byte-jlz/MediKiosk_hardware/hardware/bp_results/20261016_195159_110-75-82.jpg

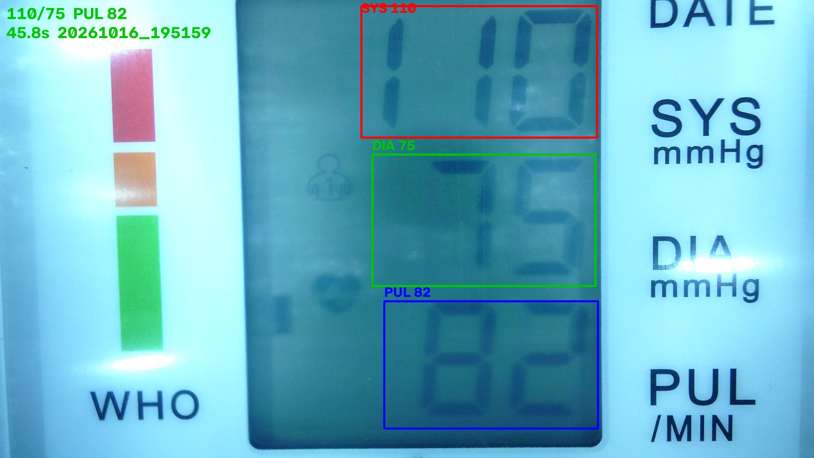
hardware/bp_results/20261016_195159_110-75-82.jpg
