byte-jlz/MediKiosk_hardware/hardware/bp_errors.csv

timestamp | code | message | after_s | picture
20261017_112818 | Er E | The BP monitor showed an error. Please check the cuff. | 17.3 | 20261017_112818_ERROR_ErE.jpg
