byte-jlz/MediKiosk_hardware/hardware/bp_snapshots/20261016_134654_DIA_binary.png

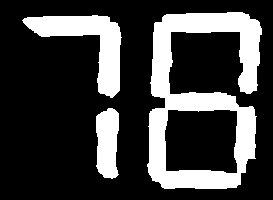
hardware/bp_snapshots/20261016_134654_DIA_binary.png
