byte-jlz/MediKiosk_hardware/hardware/bp_snapshots/20261016_140723_DIA_binary.png

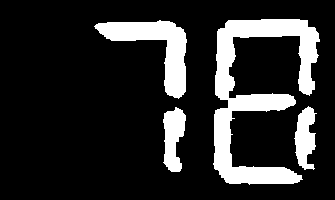
hardware/bp_snapshots/20261016_140723_DIA_binary.png
