byte-jlz/MediKiosk_hardware/hardware/bp_snapshots/20261016_140723_raw.png

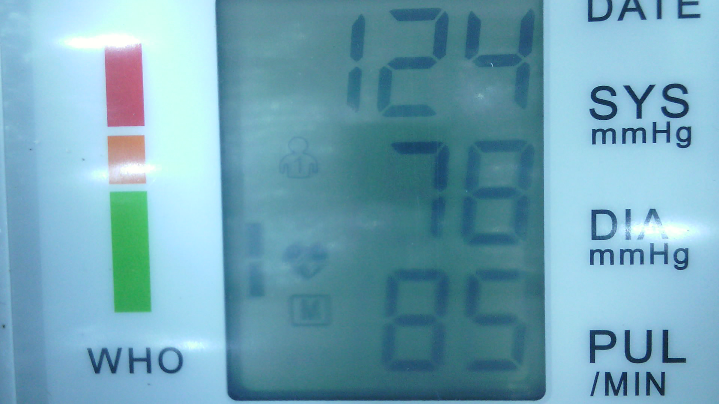
hardware/bp_snapshots/20261016_140723_raw.png
