byte-jlz/MediKiosk_hardware/hardware/bp_snapshots/20261016_141033_DIA_roi.png

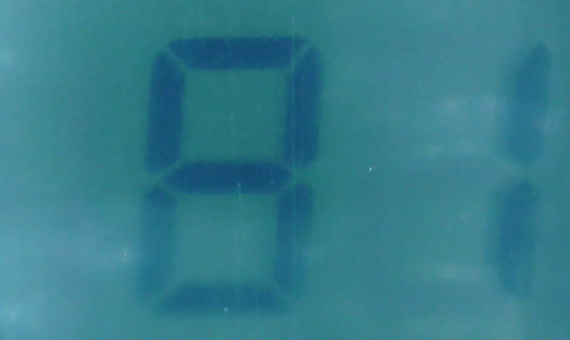
hardware/bp_snapshots/20261016_141033_DIA_roi.png
