byte-jlz/MediKiosk_hardware/hardware/bp_snapshots/20261016_141033_SYS_binary.png

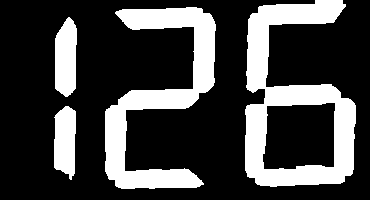
hardware/bp_snapshots/20261016_141033_SYS_binary.png
