byte-jlz/MediKiosk_hardware/hardware/bp_snapshots/20261016_194650_DIA_roi.png

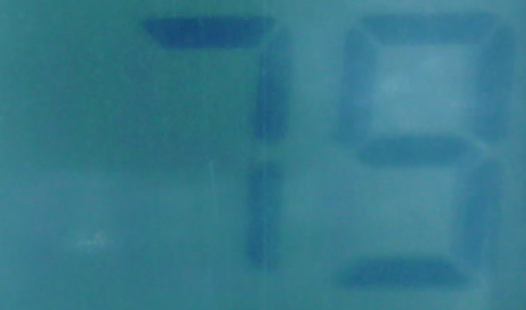
hardware/bp_snapshots/20261016_194650_DIA_roi.png
