byte-jlz/MediKiosk_hardware/hardware/bp_snapshots/20261016_194650_PUL_roi.png

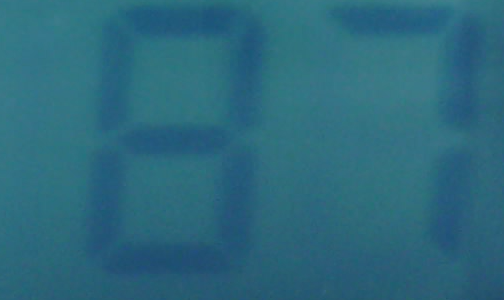
hardware/bp_snapshots/20261016_194650_PUL_roi.png
