byte-jlz/MediKiosk_hardware/hardware/bp_snapshots/20261016_194650_SYS_binary.png

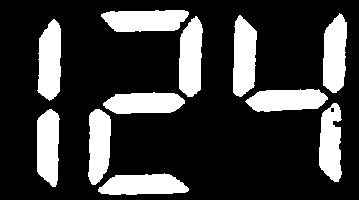
hardware/bp_snapshots/20261016_194650_SYS_binary.png
