byte-jlz/MediKiosk_hardware/hardware/bp_results.csv

timestamp | sys | dia | pul | duration_s | picture
20261016_195159 | 110 | 75 | 82 | 45.8 | 20261016_195159_110-75-82.jpg
20261016_195400 | 121 | 75 | 81 | 42.9 | 20261016_195400_121-75-81.jpg
20261016_202933 | 130 | 80 | 95 | 76.3 | 20261016_202933_130-80-95.jpg
20261016_203119 | 122 | 72 | 96 | 75.6 | 20261016_203119_122-72-96.jpg
20261017_115900 | 122 | 78 | 80 | 51.3 | 20261017_115900_122-78-80.jpg
20261017_120018 | 118 | 73 | 80 | 46.0 | 20261017_120018_118-73-80.jpg
20261017_174749 | 111 | 68 | 84 | 59.3 | 20261017_174749_111-68-84.jpg
20261017_174858 | 111 | 70 | 79 | 42.6 | 20261017_174858_111-70-79.jpg
20261017_175101 | 117 | 83 | 94 | 46.9 | 20261017_175101_117-83-94.jpg
