byte-jlz/MediKiosk_hardware/sensor_test/rr_logs/20261027_222002_rr.csv

t_s | ir_raw | breathing_wave | is_breath_peak
0.000 | 130046 | 785.80 | 0
0.040 | 129939 | 722.78 | 0
0.080 | 130109 | 656.46 | 0
0.121 | 130049 | 587.36 | 0
0.161 | 129944 | 515.99 | 0
0.201 | 129767 | 442.91 | 0
0.241 | 129469 | 368.68 | 0
0.281 | 129190 | 293.88 | 0
0.321 | 129005 | 219.09 | 0
0.362 | 128914 | 144.87 | 0
0.402 | 128876 | 71.80 | 0
0.442 | 128857 | 0.42 | 0
0.482 | 128967 | -68.74 | 0
0.522 | 128993 | -135.19 | 0
0.562 | 128371 | -198.47 | 0
0.603 | 127415 | -258.15 | 0
0.643 | 127007 | -313.85 | 0
0.683 | 126985 | -365.24 | 0
0.723 | 127020 | -412.04 | 0
0.763 | 127170 | -454.02 | 0
0.803 | 127305 | -491.01 | 0
0.844 | 127394 | -522.90 | 0
0.884 | 127473 | -549.64 | 0
0.924 | 127552 | -571.23 | 0
0.964 | 127654 | -587.75 | 0
1.004 | 127962 | -599.31 | 0
1.044 | 128107 | -606.09 | 0
1.085 | 128394 | -608.32 | 0
1.125 | 128363 | -606.30 | 0
1.165 | 127611 | -600.33 | 0
1.205 | 127118 | -590.80 | 0
1.245 | 127052 | -578.10 | 0
1.285 | 127201 | -562.67 | 0
1.326 | 127394 | -544.96 | 0
1.366 | 127635 | -525.46 | 0
1.406 | 127866 | -504.66 | 0
1.446 | 127947 | -483.04 | 0
1.486 | 128108 | -461.11 | 0
1.526 | 128312 | -439.35 | 0
1.567 | 128547 | -418.23 | 0
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
