byte-jlz/MediKiosk_hardware/sensor_test/rr_logs/20261027_223100_rr.csv

t_s | ir_raw | breathing_wave | is_breath_peak
0.000 | 135526 | 323.27 | 0
0.040 | 135669 | 335.74 | 0
0.080 | 135706 | 348.46 | 0
0.121 | 135059 | 361.32 | 0
0.161 | 134633 | 374.15 | 0
0.201 | 134647 | 386.78 | 0
0.241 | 134774 | 399.02 | 0
0.281 | 134884 | 410.67 | 0
0.321 | 135051 | 421.51 | 0
0.362 | 134978 | 431.32 | 0
0.402 | 134910 | 439.89 | 0
0.442 | 134939 | 446.98 | 0
0.482 | 135072 | 452.36 | 0
0.522 | 135227 | 455.83 | 0
0.562 | 135501 | 457.17 | 0
0.603 | 135844 | 456.19 | 0
0.643 | 136310 | 452.70 | 0
0.683 | 136553 | 446.54 | 0
0.723 | 135946 | 437.57 | 0
0.763 | 135580 | 425.69 | 0
0.803 | 135658 | 410.79 | 0
0.844 | 135816 | 392.82 | 0
0.884 | 135895 | 371.76 | 0
0.924 | 135877 | 347.62 | 0
0.964 | 135741 | 320.43 | 0
1.004 | 135520 | 290.28 | 0
1.044 | 135426 | 257.28 | 0
1.085 | 135413 | 221.57 | 0
1.125 | 135399 | 183.33 | 0
1.165 | 135393 | 142.79 | 0
1.205 | 135354 | 100.19 | 0
1.245 | 135335 | 55.81 | 0
1.285 | 135036 | 9.96 | 0
1.326 | 134281 | -37.05 | 0
1.366 | 133806 | -84.85 | 0
1.406 | 133799 | -133.09 | 0
1.446 | 133925 | -181.37 | 0
1.486 | 134072 | -229.31 | 0
1.526 | 134216 | -276.52 | 0
1.567 | 134181 | -322.59 | 0
1.607 | 134252 | -367.14 | 0
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
