byte-jlz/MediKiosk_hardware/sensor_test/rr_logs/20261027_225713_rr.csv

t_s | ir_raw | breathing_wave | is_breath_peak
0.000 | 133057 | 342.77 | 0
0.040 | 133068 | 272.78 | 0
0.080 | 133141 | 198.92 | 0
0.121 | 133219 | 121.78 | 0
0.161 | 133161 | 42.00 | 0
0.201 | 133014 | -39.77 | 0
0.241 | 132797 | -122.84 | 0
0.281 | 132703 | -206.52 | 0
0.321 | 132675 | -290.09 | 0
0.362 | 132749 | -372.86 | 0
0.402 | 132847 | -454.14 | 0
0.442 | 132925 | -533.24 | 0
0.482 | 132930 | -609.50 | 0
0.522 | 132919 | -682.30 | 0
0.562 | 132529 | -751.05 | 0
0.603 | 132062 | -815.20 | 0
0.643 | 131988 | -874.25 | 0
0.683 | 132135 | -927.75 | 0
0.723 | 132269 | -975.31 | 0
0.763 | 132431 | -1016.61 | 0
0.803 | 132473 | -1051.37 | 0
0.844 | 132494 | -1079.40 | 0
0.884 | 132511 | -1100.57 | 0
0.924 | 132620 | -1114.82 | 0
0.964 | 132705 | -1122.16 | 0
1.004 | 132745 | -1122.66 | 0
1.044 | 132787 | -1116.45 | 0
1.085 | 132830 | -1103.75 | 0
1.125 | 132870 | -1084.82 | 0
1.165 | 132623 | -1059.98 | 0
1.205 | 132153 | -1029.60 | 0
1.245 | 132051 | -994.09 | 0
1.285 | 132169 | -953.93 | 0
1.326 | 132378 | -909.60 | 0
1.366 | 132529 | -861.64 | 0
1.406 | 132566 | -810.58 | 0
1.446 | 132562 | -757.00 | 0
1.486 | 132533 | -701.47 | 0
1.526 | 132574 | -644.57 | 0
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
