byte-jlz/MediKiosk_hardware/sensor_test/rr_logs/20261028_120343_rr.csv

t_s | ir_raw | breathing_wave | is_breath_peak
0.000 | 135555 | -902.75 | 0
0.040 | 135792 | -984.55 | 0
0.080 | 136022 | -1064.28 | 0
0.121 | 136242 | -1141.34 | 0
0.161 | 136420 | -1215.16 | 0
0.201 | 136638 | -1285.15 | 0
0.241 | 136594 | -1350.75 | 0
0.281 | 136010 | -1411.41 | 0
0.321 | 135405 | -1466.64 | 0
0.362 | 135266 | -1515.94 | 0
0.402 | 135384 | -1558.87 | 0
0.442 | 135621 | -1595.02 | 0
0.482 | 135834 | -1624.06 | 0
0.522 | 135952 | -1645.67 | 0
0.562 | 136068 | -1659.60 | 0
0.603 | 136201 | -1665.67 | 0
0.643 | 136356 | -1663.74 | 0
0.683 | 136552 | -1653.74 | 0
0.723 | 136723 | -1635.68 | 0
0.763 | 136900 | -1609.60 | 0
0.803 | 137098 | -1575.62 | 0
0.844 | 137306 | -1533.93 | 0
0.884 | 137314 | -1484.77 | 0
0.924 | 136817 | -1428.44 | 0
0.964 | 136160 | -1365.29 | 0
1.004 | 135872 | -1295.73 | 0
1.044 | 135888 | -1220.22 | 0
1.085 | 136011 | -1139.26 | 0
1.125 | 136263 | -1053.37 | 0
1.165 | 136437 | -963.15 | 0
1.205 | 136639 | -869.18 | 0
1.245 | 136739 | -772.09 | 0
1.286 | 136982 | -672.51 | 0
1.326 | 137271 | -571.10 | 0
1.366 | 137633 | -468.52 | 0
1.406 | 138108 | -365.41 | 0
1.446 | 138575 | -262.41 | 0
1.486 | 138995 | -160.17 | 0
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
