byte-jlz/MediKiosk_hardware/sensor_test/rr_logs/20261028_202421_rr.csv

t_s | ir_raw | breathing_wave | is_breath_peak
0.000 | 149123 | -666.49 | 0
0.040 | 149170 | -760.16 | 0
0.080 | 148904 | -851.47 | 0
0.120 | 148678 | -939.83 | 0
0.161 | 148620 | -1024.69 | 0
0.201 | 148693 | -1105.50 | 0
0.241 | 148778 | -1181.77 | 0
0.281 | 148919 | -1253.04 | 0
0.321 | 148963 | -1318.90 | 0
0.361 | 149041 | -1378.97 | 0
0.402 | 149087 | -1432.94 | 0
0.442 | 149170 | -1480.54 | 0
0.482 | 149294 | -1521.55 | 0
0.522 | 149432 | -1555.83 | 0
0.562 | 149545 | -1583.27 | 0
0.602 | 149667 | -1603.83 | 0
0.643 | 149460 | -1617.52 | 0
0.683 | 149168 | -1624.41 | 0
0.723 | 149096 | -1624.62 | 0
0.763 | 149194 | -1618.33 | 0
0.803 | 149282 | -1605.74 | 0
0.843 | 149420 | -1587.13 | 0
0.884 | 149444 | -1562.80 | 0
0.924 | 149527 | -1533.09 | 0
0.964 | 149582 | -1498.38 | 0
1.004 | 149625 | -1459.05 | 0
1.044 | 149641 | -1415.55 | 0
1.084 | 149705 | -1368.30 | 0
1.125 | 149849 | -1317.77 | 0
1.165 | 149841 | -1264.41 | 0
1.205 | 149493 | -1208.69 | 0
1.245 | 149195 | -1151.06 | 0
1.285 | 149109 | -1091.98 | 0
1.325 | 149192 | -1031.90 | 0
1.366 | 149268 | -971.23 | 0
1.406 | 149384 | -910.39 | 0
1.446 | 149444 | -849.75 | 0
1.486 | 149491 | -789.67 | 0
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
