byte-jlz/MediKiosk_hardware/sensor_test/rr_logs/20261030_133937_rr.csv

t_s | ir_raw | breathing_wave | is_breath_peak
0.000 | 114373 | -23.34 | 0
0.040 | 114512 | 34.70 | 0
0.080 | 114604 | 91.16 | 0
0.121 | 114684 | 145.60 | 0
0.161 | 114757 | 197.61 | 0
0.201 | 114819 | 246.81 | 0
0.241 | 114880 | 292.87 | 0
0.281 | 114835 | 335.46 | 0
0.321 | 114468 | 374.31 | 0
0.362 | 114209 | 409.20 | 0
0.402 | 114192 | 439.93 | 0
0.442 | 114078 | 466.38 | 0
0.482 | 114093 | 488.43 | 0
0.522 | 114192 | 506.06 | 0
0.562 | 114142 | 519.25 | 0
0.603 | 114206 | 528.05 | 0
0.643 | 114200 | 532.56 | 0
0.683 | 114290 | 532.91 | 0
0.723 | 114347 | 529.27 | 0
0.763 | 114434 | 521.87 | 0
0.803 | 114519 | 510.95 | 0
0.844 | 114580 | 496.79 | 0
0.884 | 114698 | 479.71 | 0
0.924 | 114560 | 460.03 | 0
0.964 | 114241 | 438.11 | 0
1.004 | 113954 | 414.32 | 0
1.045 | 113869 | 389.04 | 0
1.085 | 113804 | 362.63 | 0
1.125 | 113802 | 335.49 | 0
1.165 | 113895 | 307.98 | 0
1.205 | 113915 | 280.48 | 0
1.245 | 113990 | 253.33 | 0
1.286 | 114033 | 226.86 | 0
1.326 | 114066 | 201.39 | 0
1.366 | 114148 | 177.20 | 0
1.406 | 114213 | 154.54 | 0
1.446 | 114337 | 133.64 | 0
1.486 | 114403 | 114.68 | 0
1.527 | 114524 | 97.81 | 0
1.567 | 114633 | 83.16 | 0
1.607 | 114396 | 70.80 | 0
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
