byte-jlz/MediKiosk_hardware/sensor_test/rr_logs/20261027_223100_rr.png

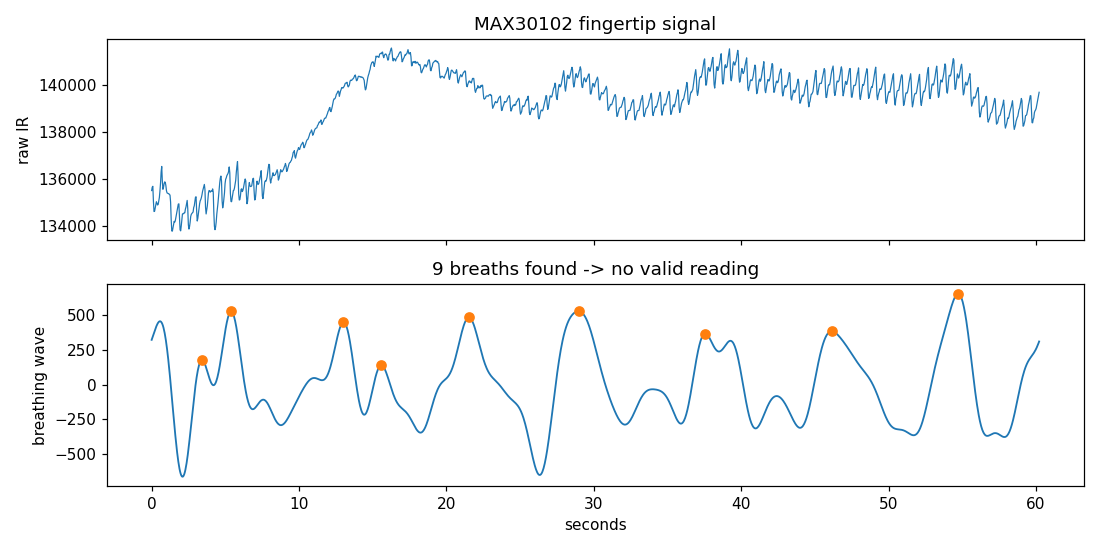
sensor_test/rr_logs/20261027_223100_rr.png
