byte-jlz/MediKiosk_hardware/sensor_test/rr_logs/20261027_225713_rr.png

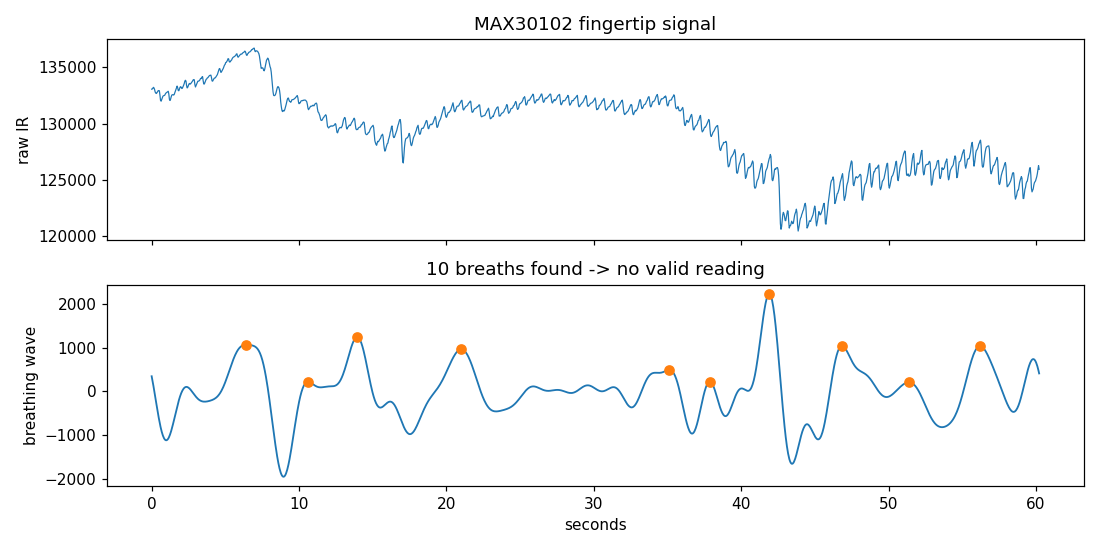
sensor_test/rr_logs/20261027_225713_rr.png
