byte-jlz/MediKiosk_hardware/sensor_test/rr_logs/20261027_234313_rr.png

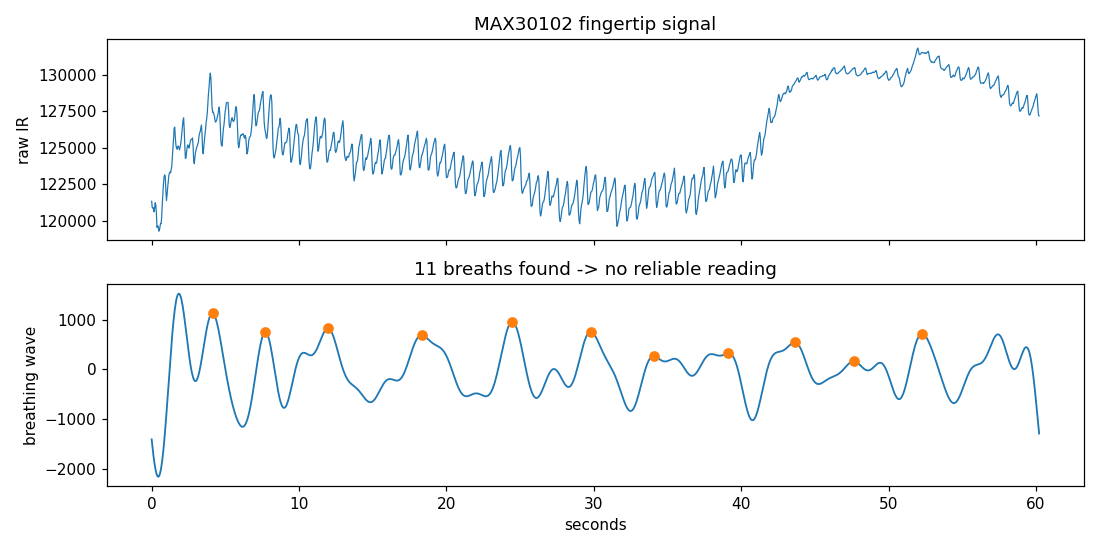
sensor_test/rr_logs/20261027_234313_rr.png
