byte-jlz/MediKiosk_hardware/sensor_test/rr_logs/20261028_201018_rr.png

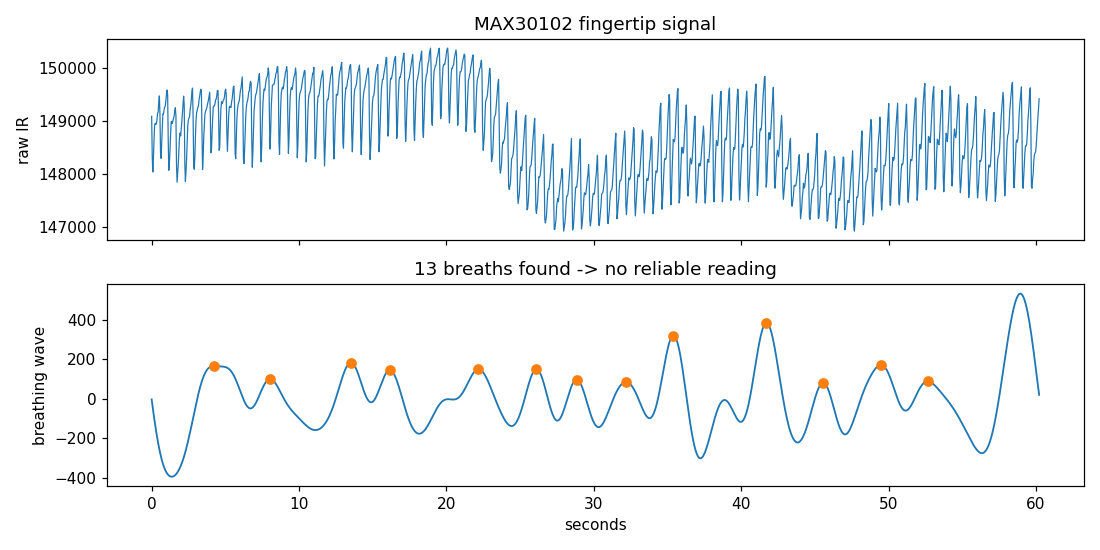
sensor_test/rr_logs/20261028_201018_rr.png
