byte-jlz/MediKiosk_hardware/sensor_test/rr_logs/20261028_202421_rr.png

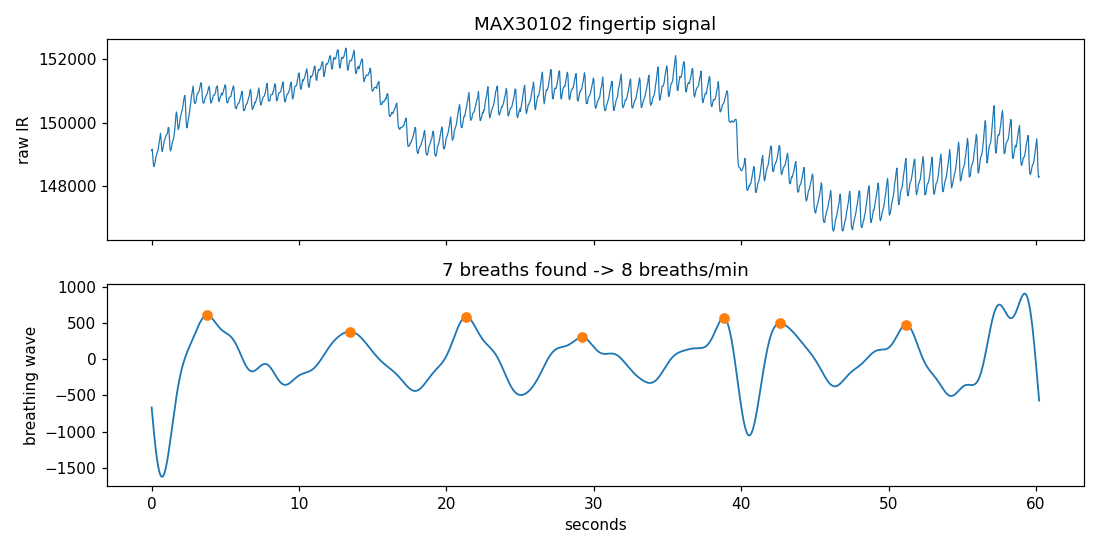
sensor_test/rr_logs/20261028_202421_rr.png
