byte-jlz/MediKiosk_hardware/sensor_test/rr_logs/20261028_204124_rr.png

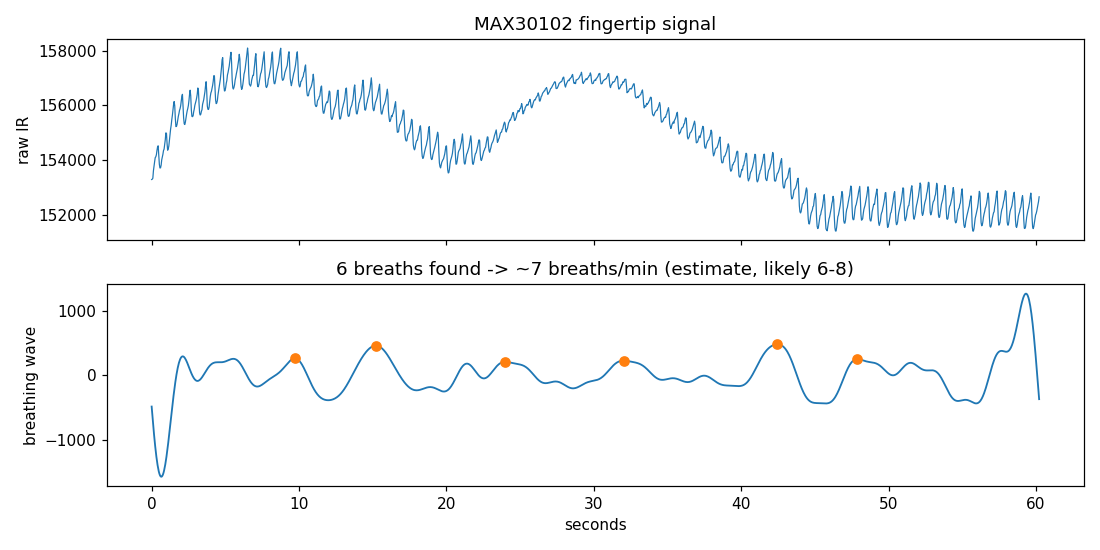
sensor_test/rr_logs/20261028_204124_rr.png
