byte-jlz/MediKiosk_hardware/sensor_test/rr_logs/20261030_083011_rr.png

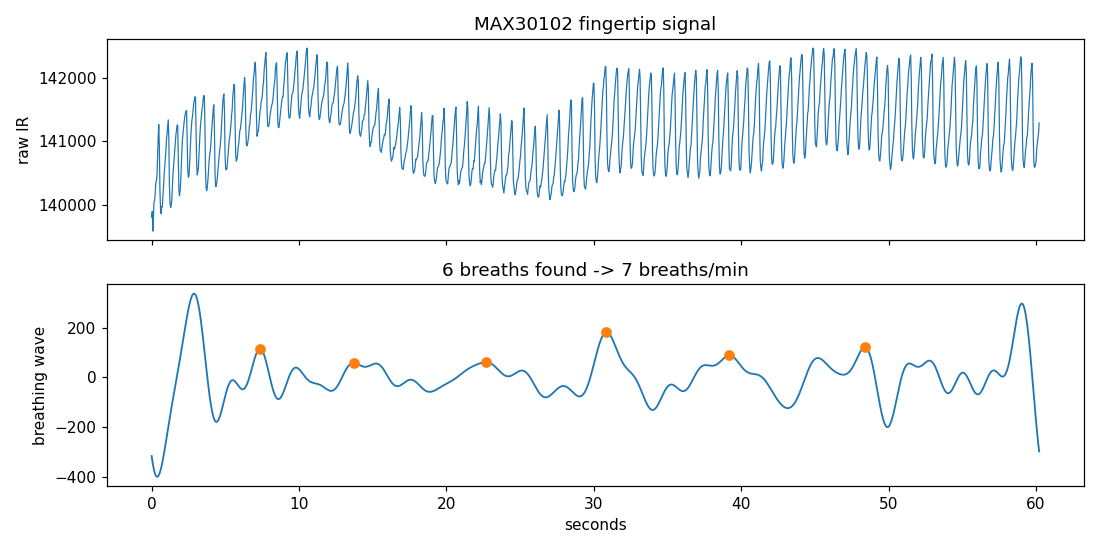
sensor_test/rr_logs/20261030_083011_rr.png
