byte-jlz/MediKiosk_hardware/sensor_test/rr_logs/20261031_175543_rr.png

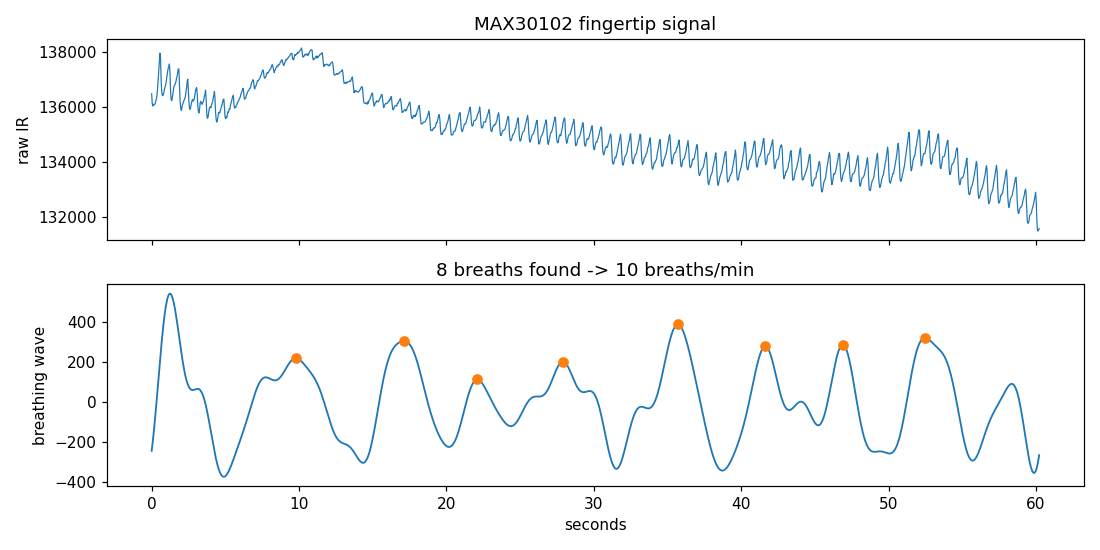
sensor_test/rr_logs/20261031_175543_rr.png
