byte-jlz/MediKiosk_hardware/sensor_test/rr_logs/20261031_182348_rr.png

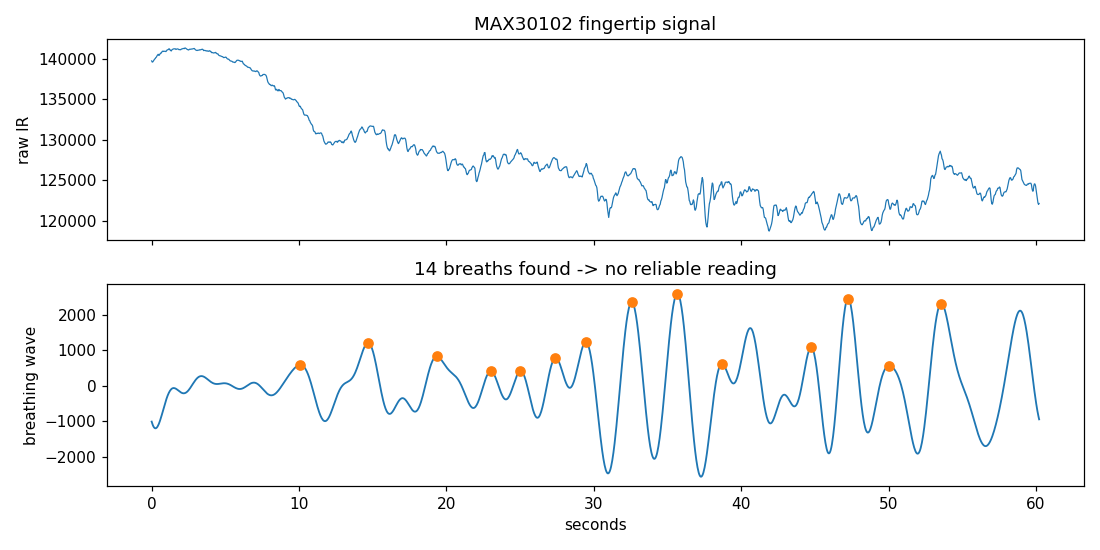
sensor_test/rr_logs/20261031_182348_rr.png
