byte-jlz/MediKiosk_hardware/sensor_test/rr_logs/20261031_184331_rr.png

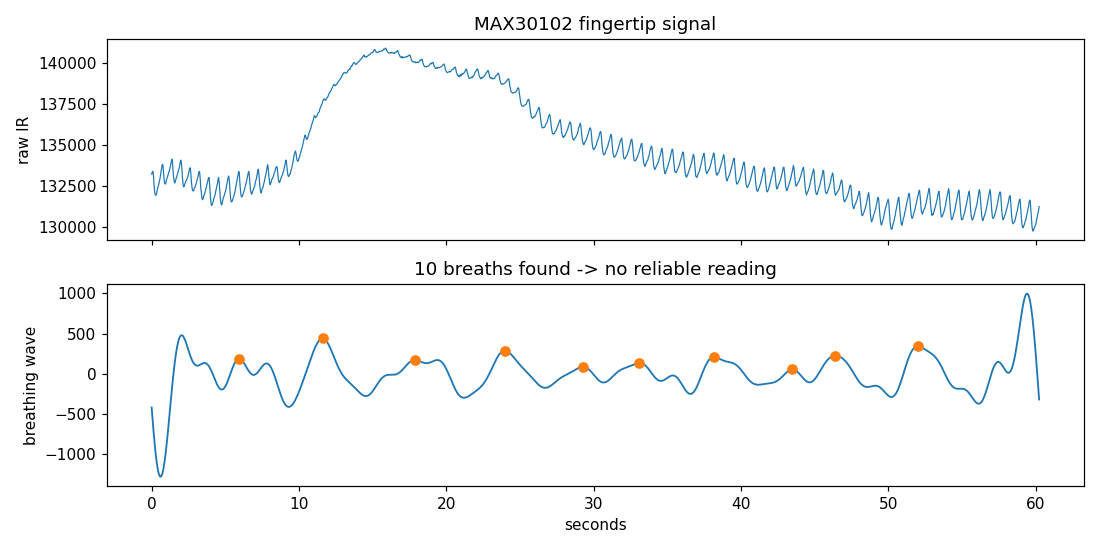
sensor_test/rr_logs/20261031_184331_rr.png
