byte-jlz/MediKiosk_hardware/test_tof.py

import time
import board
import busio
import adafruit_vl53l0x

i2c = busio.I2C(board.SCL, board.SDA)
sensor = adafruit_vl53l0x.VL53L0X(i2c)
sensor.measurement_timing_budget = 200000  # longer budget = steadier readings

while True:
    print("Distance: {} mm".format(sensor.range))
    time.sleep(0.5)
