byte-jlz/MediKiosk_hardware/(commit log)

2026-07-06 added temperature
2026-10-13 added automated button press functionality for GPIO pin 17
2026-10-16 Automatic BP: ESP32 trigger, camera reading, on/off state check
2026-10-17 lights: add ESP32 control for enclosure LEDs
2026-10-18 Port ESP32 jobs to Raspberry Pi 4B
2026-10-23 added all sensor test script for MediKiosk
2026-10-23 sensor_test: load scale calibration, use Pi pins for BP
2026-10-23 added respiratory sensor logic to the sensor_test.py
2026-10-27 added esp32 as the sole brain of the Load cell
2026-10-28 added camera path for bp cam, qr cam and esp32
2026-10-28 fix esp32 usb to the pi
2026-10-29 Scale: clear junk + drop stale readings; BP: ignore one-box camera misreads; add scale sketch
2026-10-30 Calibrate MLX90614 temperature offset (+2.9 C)
2026-10-31 BP START moved to GPIO27 (pin 13), no-pull idle
2026-10-31 RR calibration: vessel-wave fix + relaxed estimates; BP START on GPIO27
2026-11-10 added callibration in sensor.py
2026-11-10 height calibration
2026-11-10 timer in the frontend now sync with the hardware's
2026-11-10 fix camera dedicated jobs
2026-11-11 removed dev Skip login button
2026-11-11 improved fps in qr camera
